strugglebus/Contactor-Logic/README.md

Contactor Logic
===============

The electronic module which powers the MAIN, PRECHARGE, LOW-SIDE, and BLEED contactors based on the input from the front-panel switches.
