strugglebus/Contactor-Logic/Documentation/Contactor Logic schematic.pdf

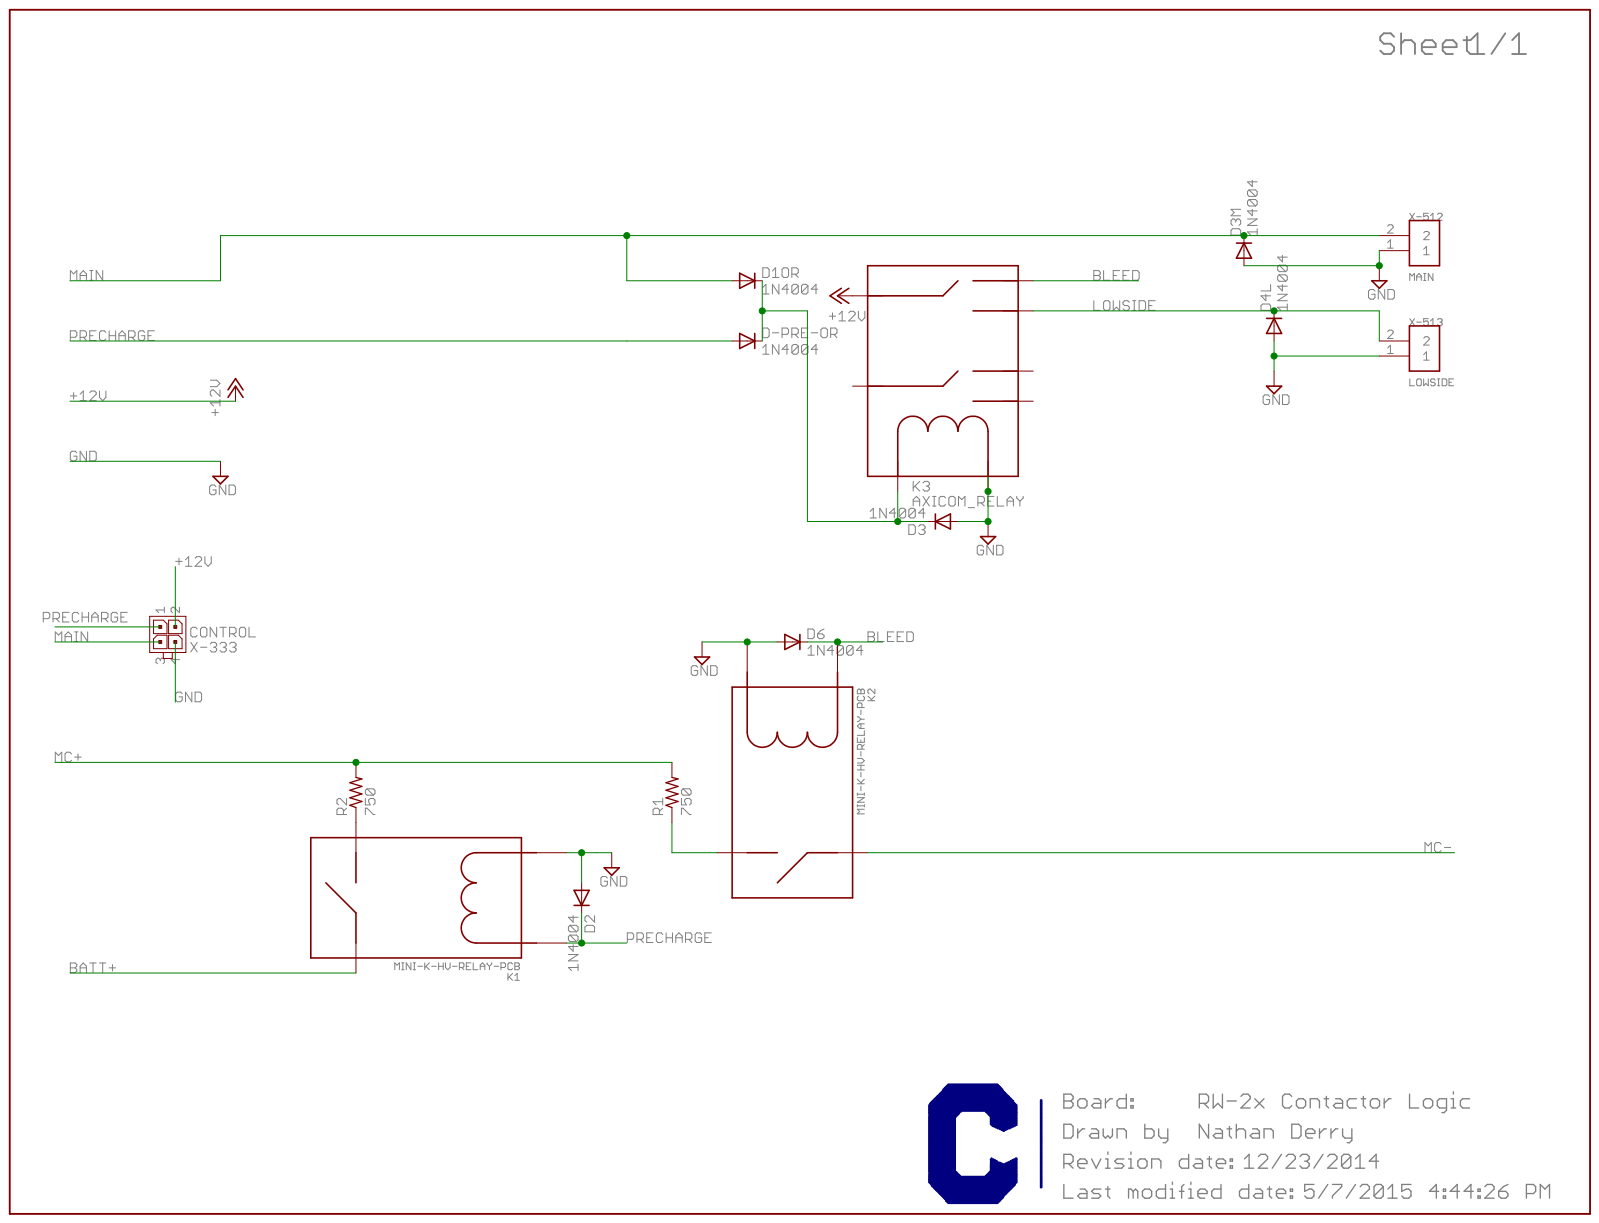
[picture p1: page 1]
