strugglebus/Contactor-Logic/Documentation/Contactor Logic - bottom.pdf

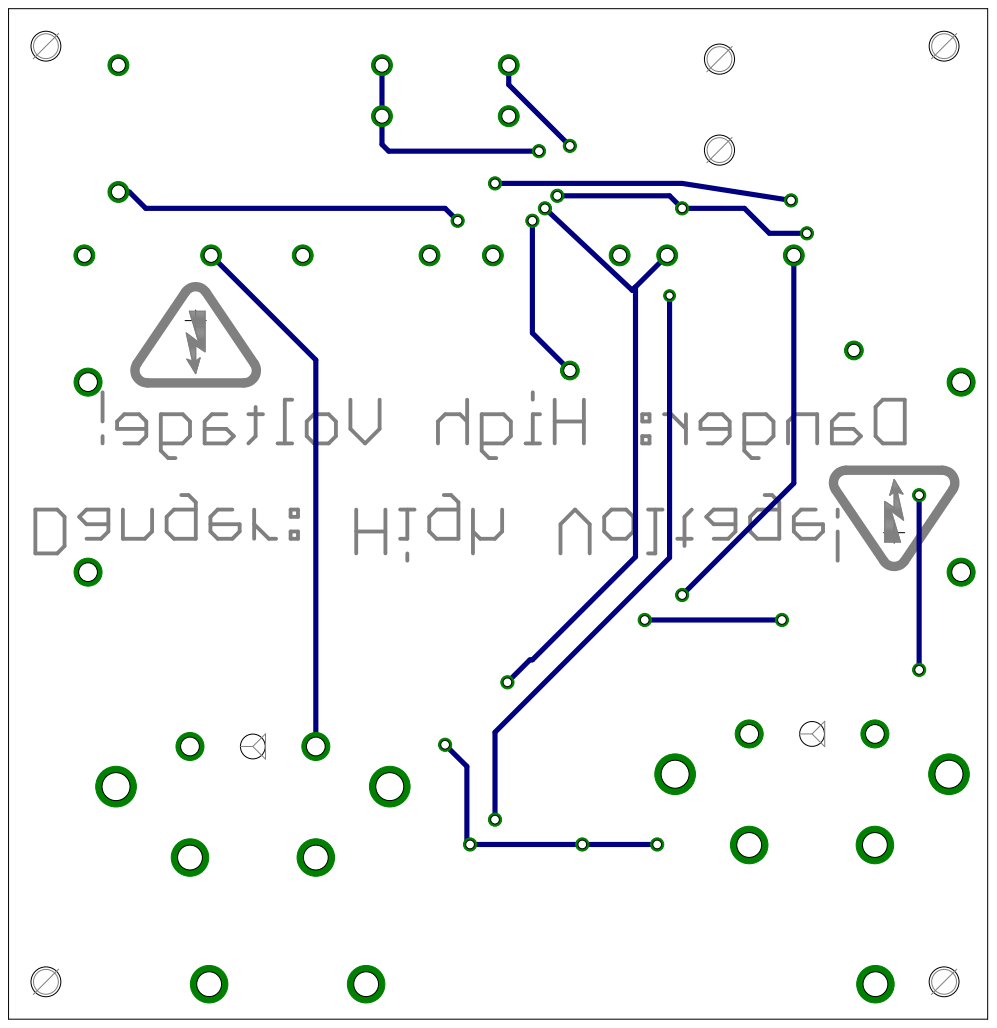
[picture p2: page 1]
