strugglebus/Contactor-Logic/Documentation/Contactor Logic - top.pdf

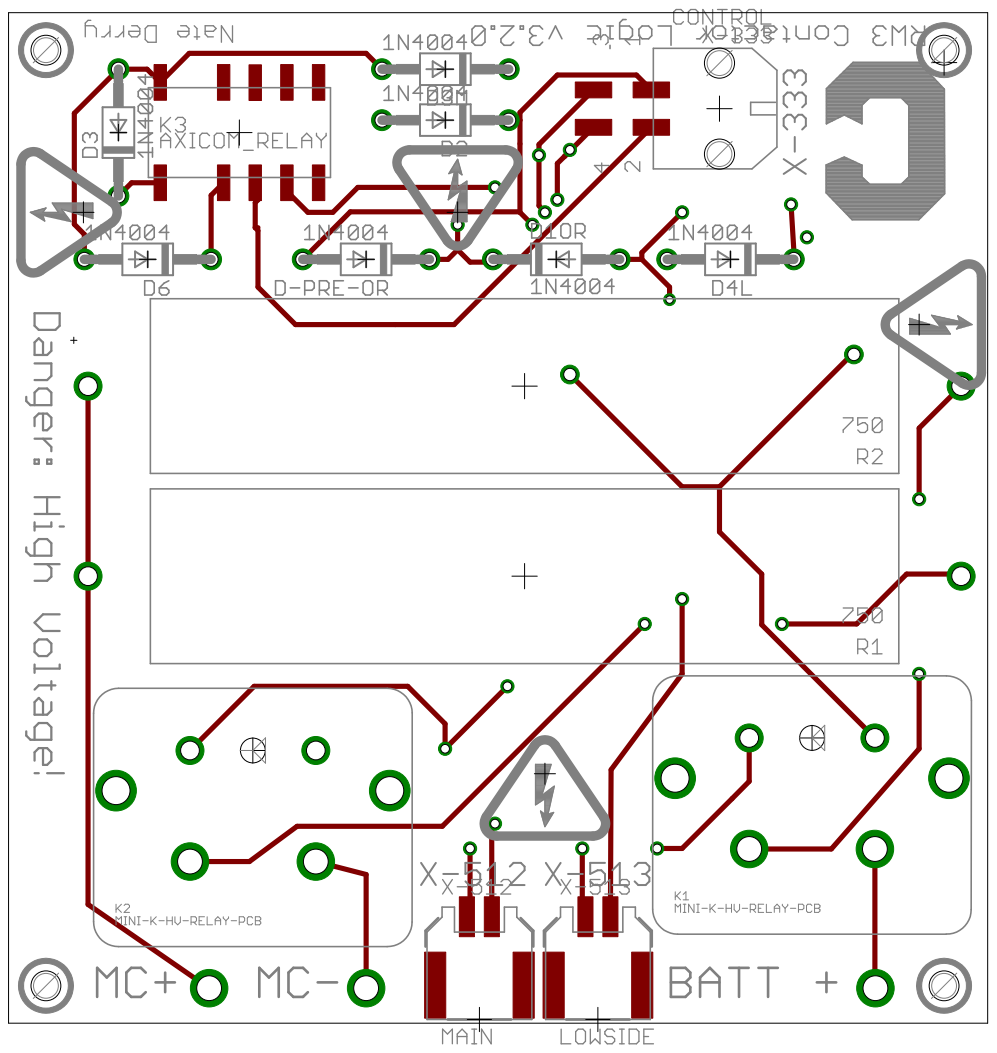
[picture p3: page 1]
