strugglebus/Contactor-Logic/(commit log)

2014-10-29 Bring RW-2x design (v2.0.0) into source control
    [Contactor Logic BOM.csv, Contactor Logic.brd, Contactor Logic.sch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]
2015-01-17 Finished Design Changes and pdfs. Need help generating gerber files and BOM. Will talk to ABK on Sunday about this.
    [Contactor Logic.brd, Contactor Logic.sch]
2015-01-28 Revised Board Design.
    [Contactor Logic.brd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]
2015-01-28 Put my name on it.
    [Contactor Logic.brd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]
2015-02-01 Found Updated BOM for v3.0.0
    [Contactor Logic BOM.csv]
2015-02-08 Fixed Vector/Proportional font issue in gerbers
    [Contactor Logic.brd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]
2015-02-13 Update compressed Gerber file to make sure it's up to date
2015-04-12 Fixed issues with Axicom Relay (coil and input pins swapped) and HV relays (coil pins swapped to correct the polarity).
    [Contactor Logic.brd, Contactor Logic.sch]
2015-04-30 FIxed Issues, Updated Gerbers and version number on board.
    [Contactor Logic.brd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]
2015-05-08 Respun Board to fit 78.5 mm width requirement and changed to M2 mounting holes.
    [Contactor Logic.brd, Contactor Logic.sch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]
2015-05-14 Fixed hole locations and moved connector into board about 21mm
    [Contactor Logic.brd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]
